Atharva-Mendhulkar/glove/papers/summaries/06_springer_2025_tinyml_rehab.md

# 06. Toward Stroke Rehabilitation: A Single Hand-Mounted IMU and TinyML for Therapeutic Hand Movement Recognition

- **Authors / Year / Venue:** TinyML Rehabilitation Group (2025); *Springer Lecture Notes / Conference Proceedings*
- **Identifier:** [10.1007/978-3-032-28829-5_11](https://link.springer.com/10.1007/978-3-032-28829-5_11)
- **Record Type:** Conference Proceedings (Peer-Reviewed)
- **Local Files:** *(Direct PDF paywalled/unavailable; see DOI / XML)* | *(No PMC XML)*

---

## 1. Hardware & Sensing Setup
Single 6-axis IMU mounted on dorsal hand, low-power embedded microcontroller.

## 2. Methodology & Algorithms
Extracted temporal statistical features from IMU windows and deployed a quantized TinyML model for therapeutic hand exercise recognition.

## 3. Reported Findings & Effect Sizes
Validated that a single hand-mounted IMU without flex/contact sensors provides sufficient discriminatory information for hand movement categorization under strict resource constraints.

## 4. Limitations & Scope Caveats
Abstract and proceedings record only; classification targeted therapeutic exercises rather than continuous tactile policy adaptation.

## 5. Direct Relevance to ESP32-S3 Glove (Architecture C)
Direct hardware precedent proving that our single dorsal IMU on ESP32-S3 can accurately classify hand movement states without requiring flex sensors.
