Atharva-Mendhulkar/glove/papers/summaries/09_ieee_whc_2025_pinch_selection.md

# 09. Augmenting Pinch Selection Using Smart Ring Vibration Feedback for Extended Reality Interaction: Perceptual Analysis and Guidelines

- **Authors / Year / Venue:** Nam & Choi (2025); *IEEE World Haptics Conference (WHC)*
- **Identifier:** [10.1109/WHC (Semantic Scholar d2cb6c008ab0a3d60999a9bbe125ffc39aa615db)](https://www.semanticscholar.org/paper/d2cb6c008ab0a3d60999a9bbe125ffc39aa615db)
- **Record Type:** Conference Paper (Peer-Reviewed)
- **Local Files:** *(Direct PDF paywalled/unavailable; see DOI / XML)* | *(No PMC XML)*

---

## 1. Hardware & Sensing Setup
Finger-mounted vibration actuator (smart ring form factor) with IMU motion tracking.

## 2. Methodology & Algorithms
Psychophysical evaluation of vibration frequency, amplitude, and timing during pinch gesture acquisition in XR.

## 3. Reported Findings & Effect Sizes
Established perceptual guidelines showing that short, sharp transients (80–120 ms) synchronize best with user grasp intention, minimizing cognitive load.

## 4. Limitations & Scope Caveats
Single-finger ring device rather than 5-finger glove array.

## 5. Direct Relevance to ESP32-S3 Glove (Architecture C)
Provides duration and frequency guidelines for finger-specific cues, particularly setting minimum ERM burst bounds that human fingers can reliably distinguish.
