Atharva-Mendhulkar/glove/papers/summaries/13_arxiv_2025_fingerpad_force_vibration.md

# 13. Unobstructed Fingerpad Force and Vibration Feedback

- **Authors / Year / Venue:** Wearable Haptics Consortium (2025); *arXiv preprint*
- **Identifier:** [arXiv:2506.21417](https://arxiv.org/abs/2506.21417)
- **Record Type:** Preprint (Open Access)
- **Local Files:** [Local PDF (`pdfs/13_arxiv_unobstructed_fingerpad_force_vibration.pdf`)](../pdfs/13_arxiv_unobstructed_fingerpad_force_vibration.pdf) | *(No PMC XML)*

---

## 1. Hardware & Sensing Setup
Finger-mounted mechanism providing combined mechanical normal force and vibrotactile stimulation while leaving the central fingerpad bare.

## 2. Methodology & Algorithms
Evaluated lateral skin stretch vs. dorsal vibration to preserve natural exploratory tactile perception during manipulation.

## 3. Reported Findings & Effect Sizes
Dorsal or lateral placement maintains high discriminability while preserving fingertip tactile sensitivity for natural object manipulation.

## 4. Limitations & Scope Caveats
Requires specialized multi-degree-of-freedom mechanical linkages beyond simple coin ERMs.

## 5. Direct Relevance to ESP32-S3 Glove (Architecture C)
Validates mounting coin ERMs on the dorsal side of each finger (proximal or distal phalanx) so the palm and fingerpads remain unobstructed for grasping.
