Atharva-Mendhulkar/glove/papers/summaries/15_bmjopen_2026_stroke_glove_rct_protocol.md

# 15. Efficacy and neural mechanisms of a vibrotactile-enhanced, brain-controlled soft robotic glove for upper limb rehabilitation after stroke: multicentre RCT protocol

- **Authors / Year / Venue:** Clinical Rehabilitation Consortium (2026); *BMJ Open*
- **Identifier:** [10.1136/bmjopen-2025-110321](https://pubmed.ncbi.nlm.nih.gov/41708167/)
- **Record Type:** Clinical Trial Protocol (Peer-Reviewed Open Access)
- **Local Files:** *(Direct PDF paywalled/unavailable; see DOI / XML)* | [Local Full-Text XML (`fulltext_xml/15_bmjopen_vibrotactile_soft_glove_rct_protocol_PMC12918676.xml`)](../fulltext_xml/15_bmjopen_vibrotactile_soft_glove_rct_protocol_PMC12918676.xml)

---

## 1. Hardware & Sensing Setup
Soft robotic glove with integrated vibrotactile stimulation and brain-computer interface (BCI).

## 2. Methodology & Algorithms
Protocol for a 48-patient, multi-center, single-blind randomized controlled trial comparing soft robotic glove with vs. without vibrotactile sensory feedback.

## 3. Reported Findings & Effect Sizes
Defines rigorous clinical trial endpoints: Fugl-Meyer Assessment (FMA-UE), Action Research Arm Test (ARAT), and cortical functional connectivity.

## 4. Limitations & Scope Caveats
Study protocol without clinical trial completion data; requires multi-center medical ethics oversight.

## 5. Direct Relevance to ESP32-S3 Glove (Architecture C)
Serves as an essential methodological cautionary standard: establishes why an engineering validation of our glove cannot claim 'stroke rehabilitation efficacy' without a full clinical RCT.
