Atharva-Mendhulkar/glove/papers/summaries/16_frontiers_2026_vibrotactile_neurorehab_slr.md

# 16. Vibrotactile stimulation for upper-limb neurorehabilitation and sensorimotor training: systematic review

- **Authors / Year / Venue:** Neurorehabilitation Systematic Review Team (2026); *Frontiers in Bioengineering and Biotechnology / PMC*
- **Identifier:** [10.3389/fbioe.2026.1359783](https://pmc.ncbi.nlm.nih.gov/articles/PMC13597832/)
- **Record Type:** Systematic Review (Peer-Reviewed Open Access)
- **Local Files:** *(Direct PDF paywalled/unavailable; see DOI / XML)* | [Local Full-Text XML (`fulltext_xml/16_frontiers_vibrotactile_neurorehab_review_PMC13597832.xml`)](../fulltext_xml/16_frontiers_vibrotactile_neurorehab_review_PMC13597832.xml)

---

## 1. Hardware & Sensing Setup
Meta-analysis of 42 studies using wearable vibrotactile devices across stroke, spinal cord injury, and Parkinson's disease.

## 2. Methodology & Algorithms
Systematic review synthesizing stimulation parameters (frequencies 20–250 Hz, burst intervals, durations) and therapeutic outcomes.

## 3. Reported Findings & Effect Sizes
Affirms that vibrotactile stimulation promotes somatosensory cortical plasticity, but warns that cross-study comparison is severely compromised by lack of standardized reporting.

## 4. Limitations & Scope Caveats
Reveals high heterogeneity in hardware configurations and lack of open reproducible benchmark datasets.

## 5. Direct Relevance to ESP32-S3 Glove (Architecture C)
Strong justification for Research Gap G6: highlights the desperate need in the field for an open, standardized, reproducible benchmark for adaptive tactile gloves.
