Atharva-Mendhulkar/glove/papers/summaries/17_jner_2025_bci_soft_robotic_glove.md

# 17. Effects and neural mechanisms of a brain-computer interface-controlled soft robotic glove on upper limb function in patients with subacute stroke: RCT

- **Authors / Year / Venue:** Ji et al. (2025); *Journal of NeuroEngineering and Rehabilitation (JNER)*
- **Identifier:** [10.1186/s12984-025-01704-x](https://jneuroengrehab.biomedcentral.com/articles/10.1186/s12984-025-01704-x)
- **Record Type:** Randomized Controlled Trial (Peer-Reviewed Open Access)
- **Local Files:** [Local PDF (`pdfs/17_bmc_bci_soft_robotic_glove.pdf`)](../pdfs/17_bmc_bci_soft_robotic_glove.pdf) | *(No PMC XML)*

---

## 1. Hardware & Sensing Setup
Soft pneumatic glove with pneumatic actuators and functional near-infrared spectroscopy (fNIRS).

## 2. Methodology & Algorithms
RCT on 32 subacute stroke patients evaluating motor recovery and cortical activation changes using fNIRS before and after training.

## 3. Reported Findings & Effect Sizes
Significant improvements in hand motor scores and increased sensorimotor cortical hemodynamic activation in the intervention group.

## 4. Limitations & Scope Caveats
Pneumatic actuation requires heavy external pumps/valves; not an embedded standalone ERM glove.

## 5. Direct Relevance to ESP32-S3 Glove (Architecture C)
Provides neurophysiological baseline data on hand motor recovery and neural activation patterns to ground our long-term research roadmap.
