Atharva-Mendhulkar/glove/papers/summaries/21_patent_us11989347b2_haptic_glove.md

# 21. Haptic glove apparatus and virtual reality apparatus including the same

- **Authors / Year / Venue:** Samsung Electronics Co., Ltd. (2024 (Granted)); *US Patent 11,989,347 B2 / US 2022/0155870 A1*
- **Identifier:** [US11989347B2](https://patents.google.com/patent/US11989347B2/en)
- **Record Type:** Granted Patent (USPTO)
- **Local Files:** [Local PDF (`pdfs/21_patent_US11989347B2_haptic_glove_apparatus.pdf`)](../pdfs/21_patent_US11989347B2_haptic_glove_apparatus.pdf) | *(No PMC XML)*

---

## 1. Hardware & Sensing Setup
Haptic glove featuring subdivided vibrotactile actuators arranged across individual finger segments and palm.

## 2. Methodology & Algorithms
Multi-actuator drive circuitry coordinating spatial sensations in VR environments.

## 3. Reported Findings & Effect Sizes
Discloses hardware layout and vibration dampening structures between adjacent finger segments.

## 4. Limitations & Scope Caveats
Focuses on mechanical construction and VR scene rendering; lacks adaptive on-device human-in-the-loop ML optimization.

## 5. Direct Relevance to ESP32-S3 Glove (Architecture C)
Key prior art for multi-channel finger actuator routing and vibration isolation.
