Atharva-Mendhulkar/glove/papers/summaries/23_patent_wo2025023899a1_haptic_glove.md

# 23. A haptic glove

- **Authors / Year / Venue:** WIPO Patent Consortium (2025); *WIPO PCT Application WO 2025/023899 A1*
- **Identifier:** [WO2025023899A1](https://patents.google.com/patent/WO2025023899A1/en)
- **Record Type:** Published PCT Patent Application
- **Local Files:** [Local PDF (`pdfs/23_patent_WO2025023899A1_haptic_glove.pdf`)](../pdfs/23_patent_WO2025023899A1_haptic_glove.pdf) | *(No PMC XML)*

---

## 1. Hardware & Sensing Setup
Fingertip vibrating elements, at least one per finger digit.

## 2. Methodology & Algorithms
Control architecture delivering modular tactile feedback sequences to finger extremities.

## 3. Reported Findings & Effect Sizes
Establishes modern glove construction techniques for integrating vibration transducers into flexible textile substrates.

## 4. Limitations & Scope Caveats
Hardware integration patent; no closed-loop motion adaptation policy.

## 5. Direct Relevance to ESP32-S3 Glove (Architecture C)
Direct technical reference for 5-channel actuator placement and textile glove wiring.
