Atharva-Mendhulkar/glove/papers/summaries/25_patent_us20220326769a1_multimodal_haptic.md

# 25. Haptic device based on multimodal interface

- **Authors / Year / Venue:** Immersion Corporation (2022); *US Patent Application US 2022/0326769 A1*
- **Identifier:** [US20220326769A1](https://patents.google.com/patent/US20220326769A1/en)
- **Record Type:** Published Patent Application (USPTO)
- **Local Files:** [Local PDF (`pdfs/25_patent_US20220326769A1_multimodal_haptic_device.pdf`)](../pdfs/25_patent_US20220326769A1_multimodal_haptic_device.pdf) | *(No PMC XML)*

---

## 1. Hardware & Sensing Setup
Multimodal haptic wearable combining kinesthetic resistance and cutaneous vibrotactile feedback.

## 2. Methodology & Algorithms
Synthesizes compound tactile feedback profiles based on user interaction states.

## 3. Reported Findings & Effect Sizes
Discloses signal processing architectures for multi-point tactile rendering.

## 4. Limitations & Scope Caveats
Broad patent claims covering multimodal hardware setups.

## 5. Direct Relevance to ESP32-S3 Glove (Architecture C)
Prior art defining standard haptic profile synthesis across wearable devices.
