Atharva-Mendhulkar/glove/papers/summaries/26_patent_us10698492b2_multisensory_hmi.md

# 26. Wearable electronic, multi-sensory haptic human-machine interface

- **Authors / Year / Venue:** Meta Platforms Technologies, LLC (2020 (Granted)); *US Patent 10,698,492 B2*
- **Identifier:** [US10698492B2](https://patents.google.com/patent/US10698492B2/en)
- **Record Type:** Granted Patent (USPTO)
- **Local Files:** [Local PDF (`pdfs/26_patent_US10698492B2_wearable_multisensory_interface.pdf`)](../pdfs/26_patent_US10698492B2_wearable_multisensory_interface.pdf) | *(No PMC XML)*

---

## 1. Hardware & Sensing Setup
Wearable sensor and actuator array with calibration processor.

## 2. Methodology & Algorithms
Per-user calibration and parameter mapping for multi-sensory wearable human-machine interfaces.

## 3. Reported Findings & Effect Sizes
Details calibration protocols for adjusting haptic intensity according to individual user threshold curves.

## 4. Limitations & Scope Caveats
Focuses on generalized calibration algorithms; does not specify embedded IMU motion-conditioned five-channel ERM scheduling.

## 5. Direct Relevance to ESP32-S3 Glove (Architecture C)
Key prior art for user-specific haptic calibration; our system differentiates through lightweight embedded staircase calibration under strict memory bounds.
