Atharva-Mendhulkar/glove/papers/summaries/27_patent_applications_2026_glove_systems.md

# 27. Haptic glove systems with segmented material-dependent actuation

- **Authors / Year / Venue:** International Patent Filings (2025–2026); *WO 2026/128417 A1 / US 2026/0161235 A1*
- **Identifier:** [WO2026128417A1](https://patents.google.com/patent/WO2026128417A1/en)
- **Record Type:** Future Patent Applications (Published Pipeline)
- **Local Files:** *(Direct PDF paywalled/unavailable; see DOI / XML)* | *(No PMC XML)*

---

## 1. Hardware & Sensing Setup
Glove systems with fingertip/segment vibration and material-dependent intensity/duration profiles.

## 2. Methodology & Algorithms
Modulates vibration duration and duty cycle depending on virtual contact material properties.

## 3. Reported Findings & Effect Sizes
Highlights industry shift toward fine-grained material and context modulation.

## 4. Limitations & Scope Caveats
Recent/future application pipeline; unverified full claims.

## 5. Direct Relevance to ESP32-S3 Glove (Architecture C)
Documents current patent landscape trends toward context-dependent actuation envelopes.
