Atharva-Mendhulkar/glove/papers/summaries/29_frontiers_2024_electrotactile_taxonomy.md

# 29. Electrotactile displays: taxonomy, cross-modality, psychophysics and challenges

- **Authors / Year / Venue:** Tactile Displays Group (2024); *Frontiers in Virtual Reality*
- **Identifier:** [10.3389/frvir.2024.1406923](https://www.frontiersin.org/journals/virtual-reality/articles/10.3389/frvir.2024.1406923/full)
- **Record Type:** Comprehensive Review (Peer-Reviewed Open Access)
- **Local Files:** [Local PDF (`pdfs/29_frontiers_electrotactile_displays_taxonomy.pdf`)](../pdfs/29_frontiers_electrotactile_displays_taxonomy.pdf) | *(No PMC XML)*

---

## 1. Hardware & Sensing Setup
Survey of surface tactile display modalities (electrotactile, vibrotactile, ultrasound).

## 2. Methodology & Algorithms
Taxonomic classification of cutaneous receptor populations, perceptual masking, two-point discrimination limits, and psychophysical evaluation methods.

## 3. Reported Findings & Effect Sizes
Details two-point spatial discrimination thresholds across the hand (2–4 mm at fingertip vs. 8–10 mm at palm) and cross-modal temporal masking curves.

## 4. Limitations & Scope Caveats
Focuses primarily on electrotactile stimulation; mechanical wave propagation differs from current delivery.

## 5. Direct Relevance to ESP32-S3 Glove (Architecture C)
Provides the psychophysical basis for channel isolation: explains why 5 distinct fingers offer natural anatomical isolation compared to dense forearm arrays.
