Atharva-Mendhulkar/glove/papers/summaries/10_chi_2025_hapticus.md

# 10. Hapticus: Exploring the Effects of Haptic Feedback and its Customization on Motor Skill Learning

- **Authors / Year / Venue:** Lee, Yang, et al. (2025); *ACM CHI Conference on Human Factors in Computing Systems*
- **Identifier:** [10.1145/3706598.3713821](https://doi.org/10.1145/3706598.3713821)
- **Record Type:** Conference Paper (Peer-Reviewed)
- **Local Files:** *(Direct PDF paywalled/unavailable; see DOI / XML)* | *(No PMC XML)*

---

## 1. Hardware & Sensing Setup
Customizable multi-point haptic wearable interface.

## 2. Methodology & Algorithms
Controlled human study testing fixed versus user-customized tactile guidance during fine motor skill acquisition tasks.

## 3. Reported Findings & Effect Sizes
Customized tactile parameters (user-selected amplitude, pulse spacing) significantly accelerated skill acquisition and improved subjective user comfort compared to static presets.

## 4. Limitations & Scope Caveats
Interactive customization required user manual adjustments rather than autonomous contextual bandit optimization.

## 5. Direct Relevance to ESP32-S3 Glove (Architecture C)
Direct experimental evidence that per-user tactile customization is not a cosmetic feature, but measurably improves task accuracy and learning speed.
