Atharva-Mendhulkar/glove/WhatsApp Image 2026-10-26 at 8.35.25 PM.jpeg

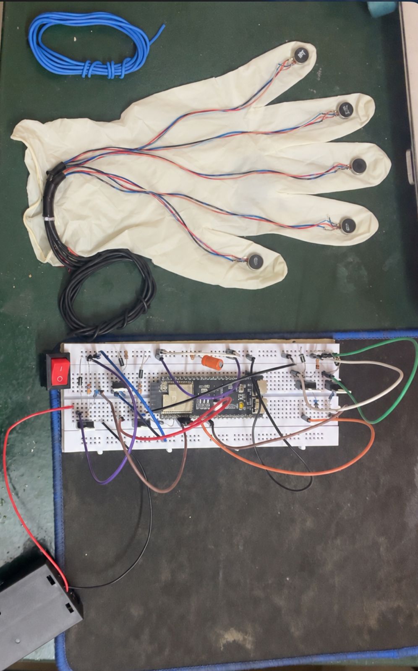
WhatsApp Image 2026-10-26 at 8.35.25 PM.jpeg
