Atharva-Mendhulkar/glove/(commit log)

2026-10-26 docs(paper): Add hardware prototype photograph, discrete component gallery, and complete BOM table
2026-10-30 feat(firmware): add dorsal IMU non-blocking auto-detection, 6-axis calibration, and telemetry bridge
2026-10-30 feat(imu): configure hardware IMU on SDA=GPIO3 and SCL=GPIO10, verify MPU-6500 calibration
2026-10-30 feat: update ESP32-S3 glove firmware for direct DC motor driving, add GPIO scanner, and include software documentation
